Sonosus/Big_Honking_Button/hardware/board/board.kicad_pcb

## KiCad design hardware/board/board.kicad_pcb (2021-11-18)

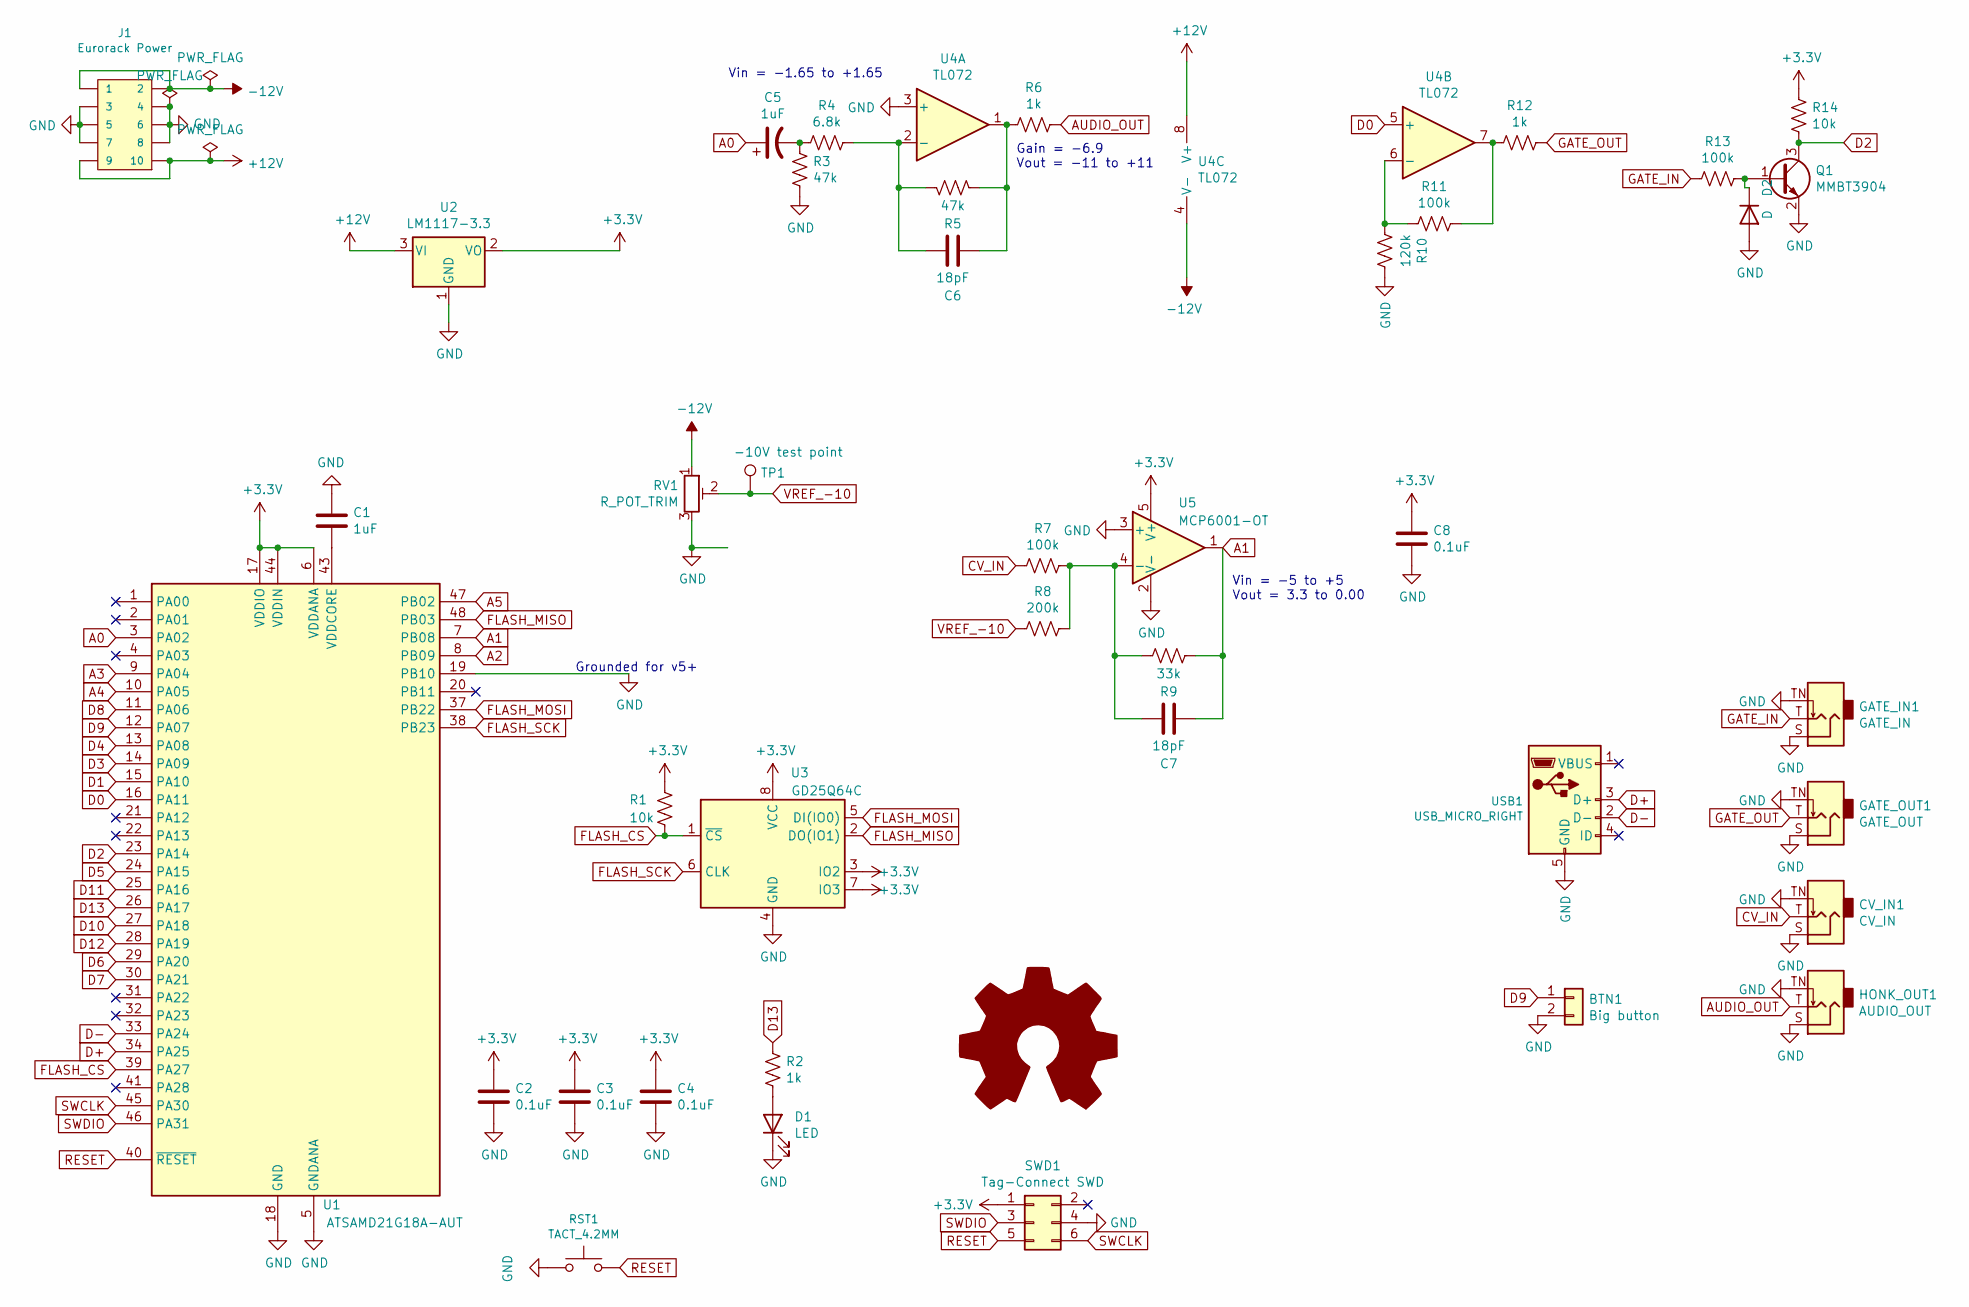
[picture p1: schematic board.kicad_sch, Big Honking Button]

Parts:
BTN1: Big button; PinHeader_1x02_P2.54mm_Vertical; mpn OBSF-30
C1: 1uF; Capacitor_NonPolarized; mpn MF-CAP-0603-1uF
C2, C3, C4, C8: 0.1uF; Capacitor_NonPolarizedSmall; mpn MF-CAP-0603-0.1uF
C5: 1uF; Capacitor_Polarized; mpn MF-CAP-0603-1uF
C6, C7: 18pF; Capacitor_NonPolarized; mpn MF-CAP-0603-18pF
CV_IN1: CV_IN; Jack_6.35mm_PJ_629HAN; mpn WQP-PJ398SM
D1: LED; LED_D5.0mm; mpn MF-LED-0603-GREEN
D2: D; Diode_DO-35; mpn MF-DIO-SOD123-1N4148
GATE_IN1: GATE_IN; Jack_6.35mm_PJ_629HAN; mpn WQP-PJ398SM
GATE_OUT1: GATE_OUT; Jack_6.35mm_PJ_629HAN; mpn WQP-PJ398SM
HONK_OUT1: AUDIO_OUT; Jack_6.35mm_PJ_629HAN; mpn WQP-PJ398SM
J1: Eurorack Power; Power_Header; mpn 61201021621
Q1: MMBT3904; Transistor_TO-92; mpn MF-DSC-SOT233-MMBT3904
R1, R14: 10k; Resistor; mpn MF-RES-0603-10K
R2: 1k; R_Axial_DIN0207_L6.3mm_D2.5mm_P2.54mm_Vertical; mpn MF-RES-0603-1K
R3, R5: 47k; Resistor; mpn ERA-3AED473V
R4: 6.8k; Resistor; mpn ERA-3AED682V
R6, R12: 1k; Resistor; mpn MF-RES-0603-1K
R7, R13: 100k; Resistor; mpn ERA-3AED104V
R8: 200k; Resistor; mpn ERA-3AEB204V
R9: 33k; Resistor; mpn ERA-3AED333V
R10: 120k; Resistor; mpn MF-RES-0603-1K
R11: 100k; Resistor; mpn MF-RES-0603-1K
RST1: TACT_4.2MM; PinHeader_1x02_P2.54mm_Vertical; mpn MF-SW-TACT-4.2MM
RV1: R_POT_TRIM; Potentiometer_Bourns_3296W_Vertical
SWD1: Tag-Connect SWD; PinHeader_2x03_P2.54mm_Vertical
TP1: -10V test point; TestPoint_Plated_Hole_D3.0mm
U1: ATSAMD21G18A-AUT; TQFP-48_7x7mm_P0.5mm; mpn ATSAMD21G18A-AUT
U2: LM1117-3.3; Regulator_TO-220-3
U3: GD25Q64C; SOIC-8_5.23x5.23mm_P1.27mm; mpn GD25Q64CSIGR
U4: TL072; DIP-8_Socket; mpn TL072CPWR
U5: MCP6001-OT; SOT-23-5; mpn MCP6001T-I/OT
USB1: USB_MICRO_RIGHT; Connector_USB_Micro_Tayda_A-5228; mpn MF-CON-MICROUSB-RIGHT

Connections:
+3V3: C2.1, C3.1, C4.1, C8.1, R1.1, R14.2, SWD1.1, U1.6 (VDDANA), U1.17 (VDDIO), U1.36 (VDDIO), U1.44 (VDDIN), U2.2 (VO), U3.3 (IO2), U3.7 (IO3), U3.8 (VCC), U5.5 (V+)
+12V: J1.9, J1.10, U2.3 (VI), U4.8 (V+)
-12V: J1.1, J1.2, RV1.1, U4.4 (V-)
A0: C5.1, U1.3 (PA02)
A1: C7.1, R9.1, U1.7 (PB08), U5.1
A2: U1.8 (PB09)
A3: U1.9 (PA04)
A4: U1.10 (PA05)
A5: U1.47 (PB02)
AUDIO_OUT: HONK_OUT1.T, R6.1
CV_IN: CV_IN1.T, R7.2
D0: U1.16 (PA11), U4.5 (+)
D1: U1.15 (PA10)
D2: Q1.3 (C), R14.1, U1.23 (PA14)
D3: U1.14 (PA09)
D4: U1.13 (PA08)
D5: U1.24 (PA15)
D6: U1.29 (PA20)
D7: U1.30 (PA21)
D8: U1.11 (PA06)
D9: BTN1.1, U1.12 (PA07)
D10: U1.27 (PA18)
D11: U1.25 (PA16)
D12: U1.28 (PA19)
D13: R2.2, U1.26 (PA17)
D+: U1.34 (PA25), USB1.3 (D+)
D-: U1.33 (PA24), USB1.2 (D-)
FLASH_CS: R1.2, U1.39 (PA27), U3.1 (~CS)
FLASH_MISO: U1.48 (PB03), U3.2 (DO(IO1))
FLASH_MOSI: U1.37 (PB22), U3.5 (DI(IO0))
FLASH_SCK: U1.38 (PB23), U3.6 (CLK)
GATE_IN: GATE_IN1.T, R13.2
GATE_OUT: GATE_OUT1.T, R12.1
GND: BTN1.2, C1.1, C2.2, C3.2, C4.2, C8.2, CV_IN1.S, CV_IN1.TN, D1.1 (K), D2.2 (A), GATE_IN1.S, GATE_IN1.TN, GATE_OUT1.S, GATE_OUT1.TN, HONK_OUT1.S, HONK_OUT1.TN, J1.3, J1.4, J1.5, J1.6, J1.7, J1.8, Q1.2 (E), R3.1, R10.1, RST1.1, RV1.3, SWD1.4, U1.5 (GNDANA), U1.18 (GND), U1.19 (PB10), U1.35 (GND), U1.42 (GND), U2.1 (GND), U3.4 (GND), U4.3 (+), U5.2 (V-), U5.3 (+), USB1.5 (GND)
unnamed: C1.2, U1.43 (VDDCORE)
unnamed: C5.2, R3.2, R4.2
unnamed: C6.1, R5.2, R6.2, U4.1
unnamed: C6.2, R4.1, R5.1, U4.2 (-)
unnamed: C7.2, R7.1, R8.1, R9.2, U5.4 (-)
unnamed: D1.2 (A), R2.1
unnamed: D2.1 (K), Q1.1 (B), R13.1
unnamed: R10.2, R11.2, U4.6 (-)
unnamed: R11.1, R12.2, U4.7
RESET: RST1.2, SWD1.5, U1.40 (~RESET)
SWCLK: SWD1.6, U1.45 (PA30)
SWDIO: SWD1.3, U1.46 (PA31)
VREF_-10: R8.2, RV1.2, TP1.1

Notes on the sheet:
Grounded for v5+
Vin = -1.65 to +1.65
Gain = -6.9 Vout = -11 to +11
Vin = -5 to +5 Vout = 3.3 to 0.00

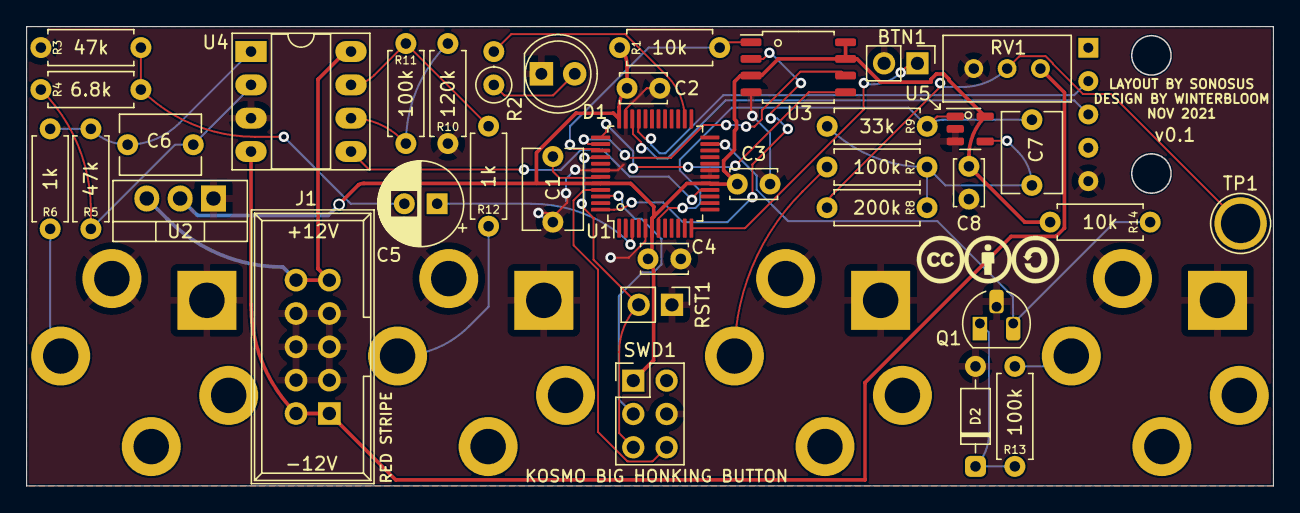
[picture p2: board board.kicad_pcb from above]

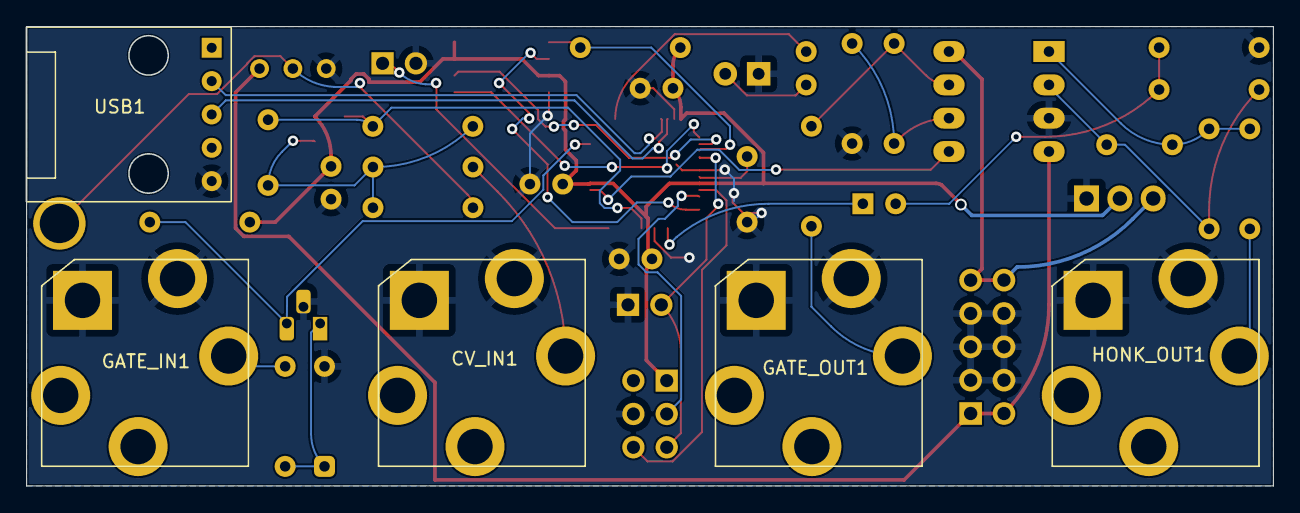
[picture p3: board board.kicad_pcb from below]

Board: 2 copper layers, 95.0 x 35.0 mm, 41 parts (5 on the bottom side), 33 nets.
