Sonosus/Big_Honking_Button/(commit log)

2021-08-08 Use unused op amp to level shift and buffer gate output
    [board.sch]
2021-08-08 Diode to protect transistor
    [board.sch]
2021-11-18 done! apologies for no commits :-)
    [board-B_Cu.gbr, board-B_Mask.gbr, board-B_Silkscreen.gbr, board-Edge_Cuts.gbr, board-F_Cu.gbr, board-F_Mask.gbr, board-F_Silkscreen.gbr, board-NPTH.drl]
2021-11-18 del redundant models
    [User Library-PJ301M-12 Thonkiconn v0_2.STEP, board.step, c-5787834-1-c-3d.step, eurorack-power.step, smt_tact.step, soic-8.step, wurth-61201021621.step]
