Sonosus/Big_Honking_Button/(notices)

Notices in the files:
hardware/board/board.kicad_sch:
CC BY-SA 4.0
